ling99LL/TAS5815/MDK-ARM/build_output.txt

*** Using Compiler 'V6.22', folder: 'C:\Keil_v5\ARM\ARMCLANG\Bin'
Build target 'stm32f411totas5815'
"stm32f411totas5815\stm32f411totas5815.axf" - 0 Error(s), 0 Warning(s).
Build Time Elapsed:  00:00:00
