ling99LL/TAS5815/Core/Inc/main.h

#define ENC_KEY_Pin GPIO_PIN_9
#define ENC_KEY_GPIO_Port GPIOB
#define BT_PAIR_Pin GPIO_PIN_12      /* PB12 - 暂停/蓝牙配对 */
#define BT_PAIR_GPIO_Port GPIOB
#define BT_VOL_DOWN_Pin GPIO_PIN_13  /* PB13 - VOL-/上一曲 */
#define BT_VOL_DOWN_GPIO_Port GPIOB
#define BT_VOL_UP_Pin GPIO_PIN_14    /* PB14 - VOL+/下一曲 */
#define BT_VOL_UP_GPIO_Port GPIOB
#define BT_USB_DET_Pin GPIO_PIN_0    /* PB0 - 蓝牙USB口检测 */
#define BT_USB_DET_GPIO_Port GPIOB
#define BT_PLAY_DET_Pin GPIO_PIN_6   /* PA6 - 播放检测 */
#define BT_PLAY_DET_GPIO_Port GPIOA
#define BT_LED0_Pin GPIO_PIN_15      /* PB15 - LED0 */
#define BT_LED0_GPIO_Port GPIOB
#define BT_LED1_Pin GPIO_PIN_4       /* PA4 - LED1 */
#define BT_LED1_GPIO_Port GPIOA
#define BT_EN_Pin GPIO_PIN_10        /* PA10 - 蓝牙模块启动，高电平有效 */
#define BT_EN_GPIO_Port GPIOA
#define PD_5V_Pin GPIO_PIN_9         /* PA9 - 5V控制，高电平有效 */
#define PD_5V_GPIO_Port GPIOA
#define PD_20V_Pin GPIO_PIN_10       /* PB10 - 20V控制，高电平有效 */
#define PD_20V_GPIO_Port GPIOB
#define PD_VOLT_DET_Pin GPIO_PIN_1   /* PB1 - 电压检测ADC (分压比: 51k/10k) */
#define PD_VOLT_DET_GPIO_Port GPIOB
