ling99LL/TAS5815/(commit log)

2026-05-15 Initial commit: STM32F411 TAS5815 audio amplifier project
2026-05-15 Initialize README with project details and features
    Add project introduction and detailed functionalities for STM32F411 TAS5815 digital audio amplifier.
2026-05-15 将图片上传到GitHub仓库，更新README.md图片链接为相对路径
